MarkDunk/1st-Year-ESE-Multimeter/Multimeter.pdf

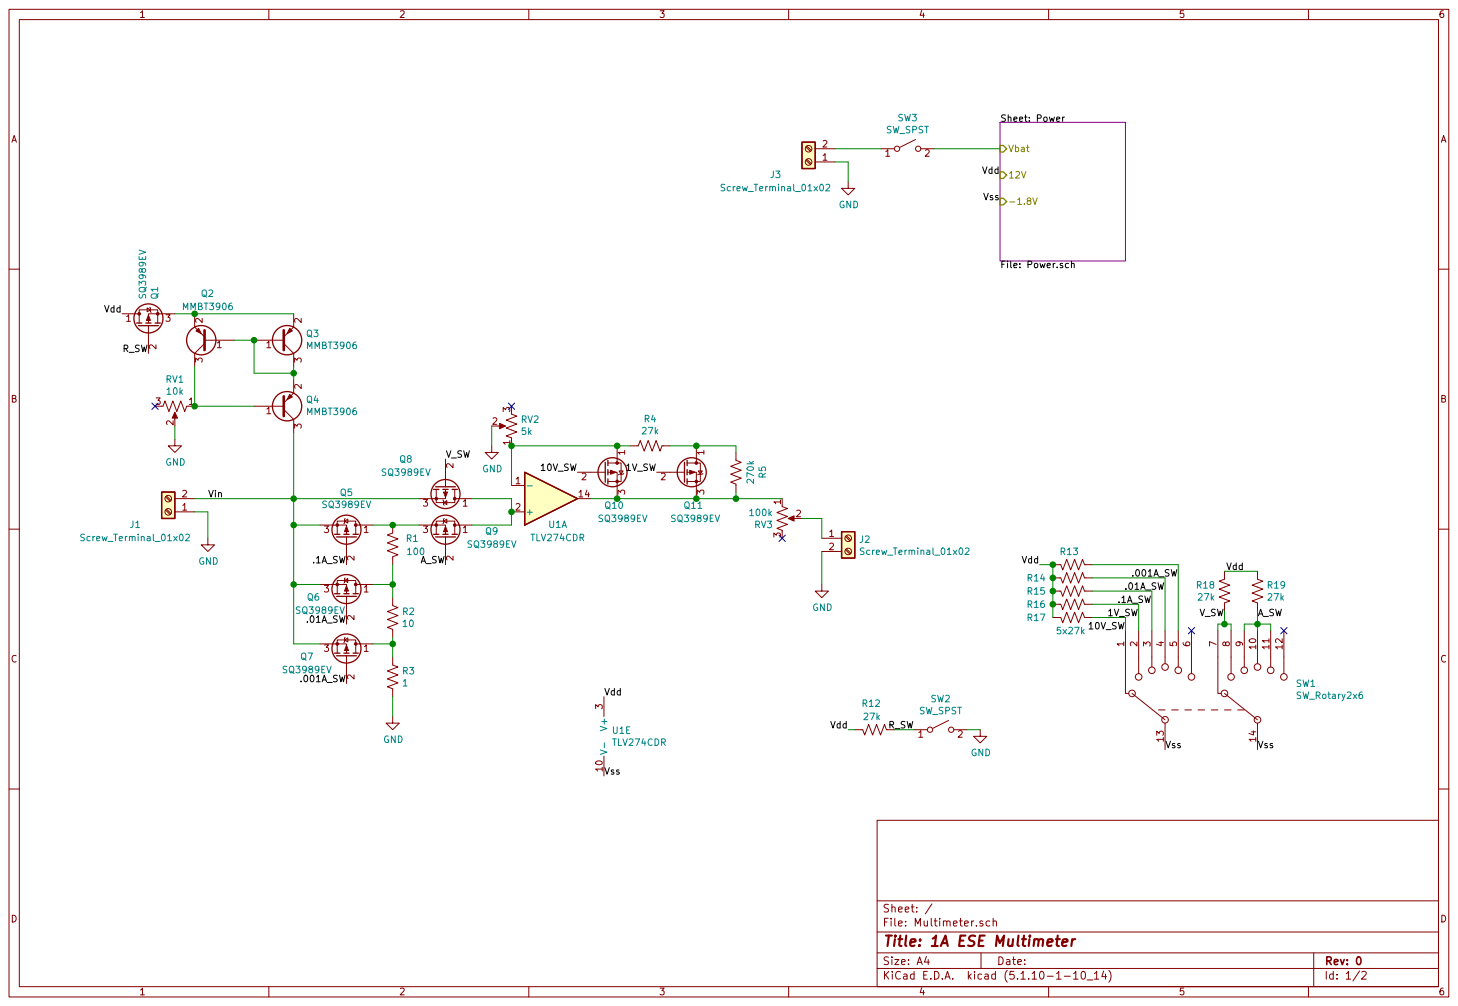
[picture p1: page 1]

Sheet: Power File: Power.sch Vbat -1.8V

Id: 1/2 Title: 1A ESE Multimeter File: Multimeter.sch Sheet: /

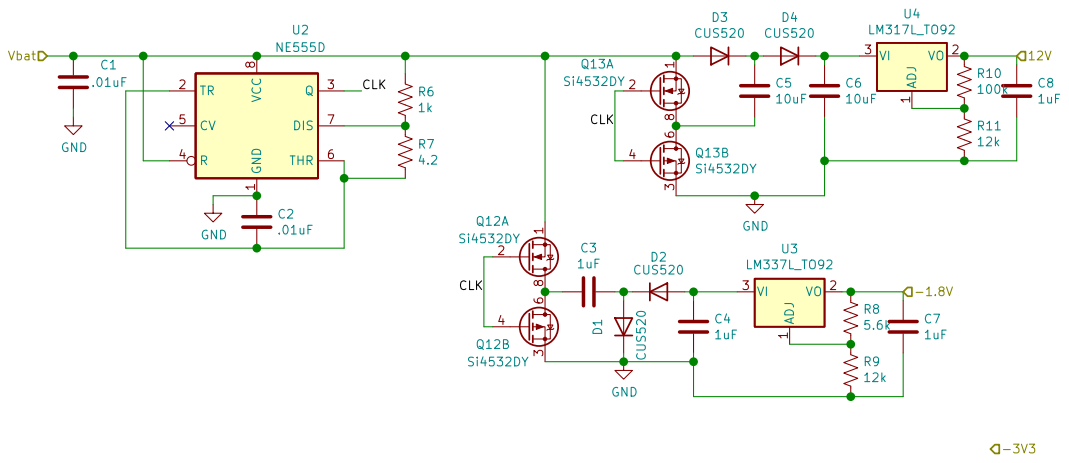
[picture p2: page 2]
