MarkDunk/1st-Year-ESE-Multimeter/PDFs/Multimeter.pdf

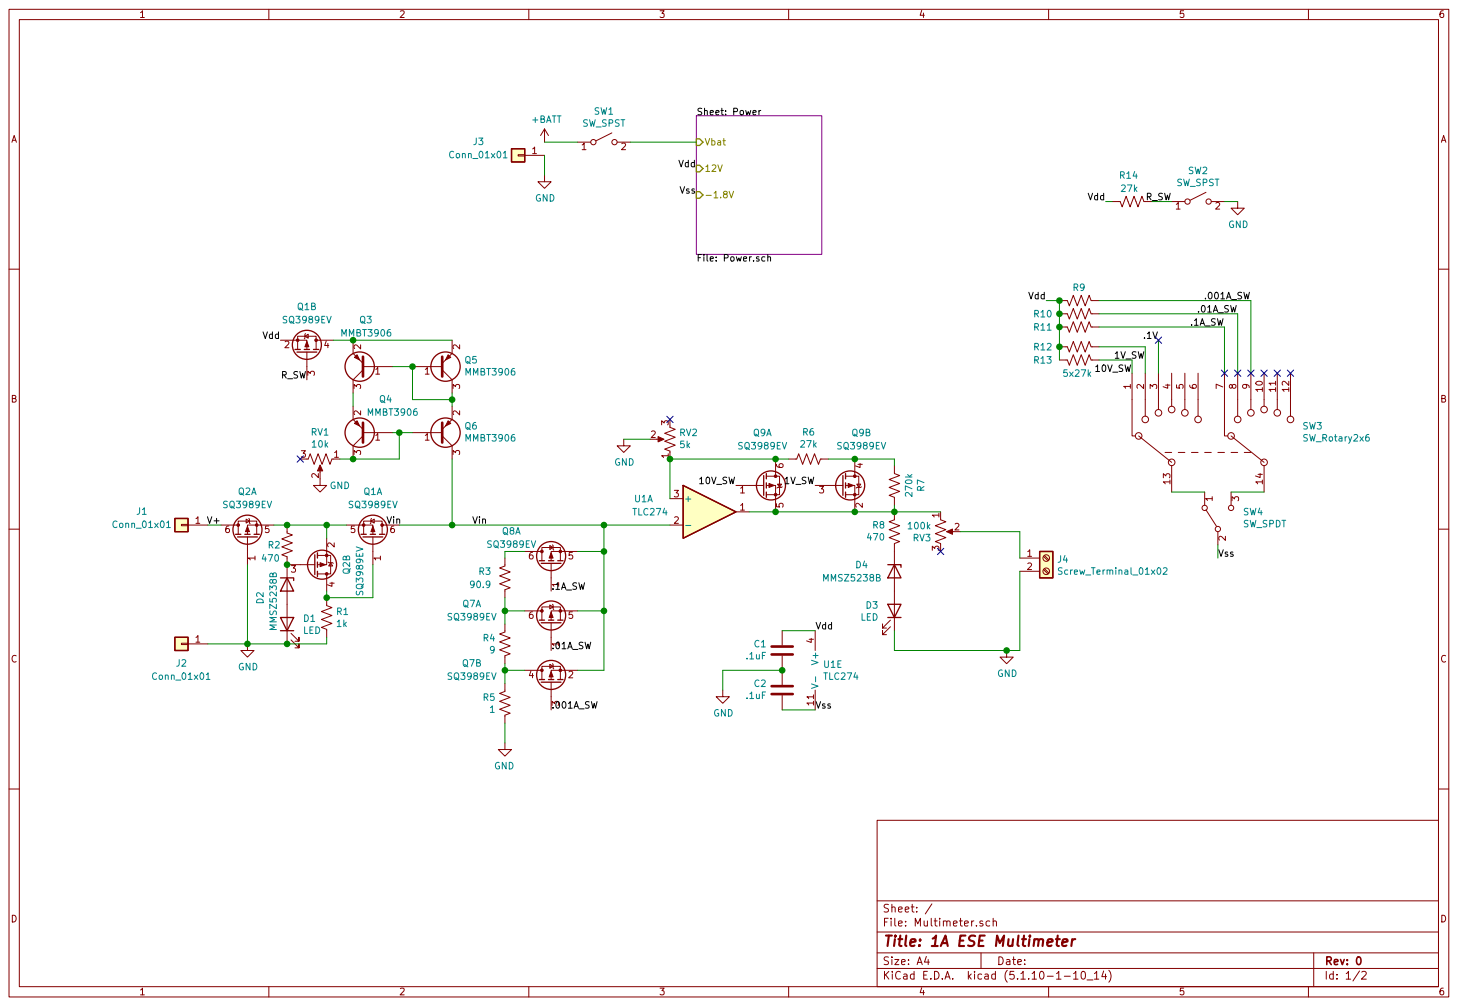
[picture p3: page 1]

Sheet: Power File: Power.sch Vbat -1.8V

9 SW3 SW_Rotary2x6 V+ Vin Vdd Vss Vin Vdd R_SW

Id: 1/2 Title: 1A ESE Multimeter File: Multimeter.sch Sheet: /

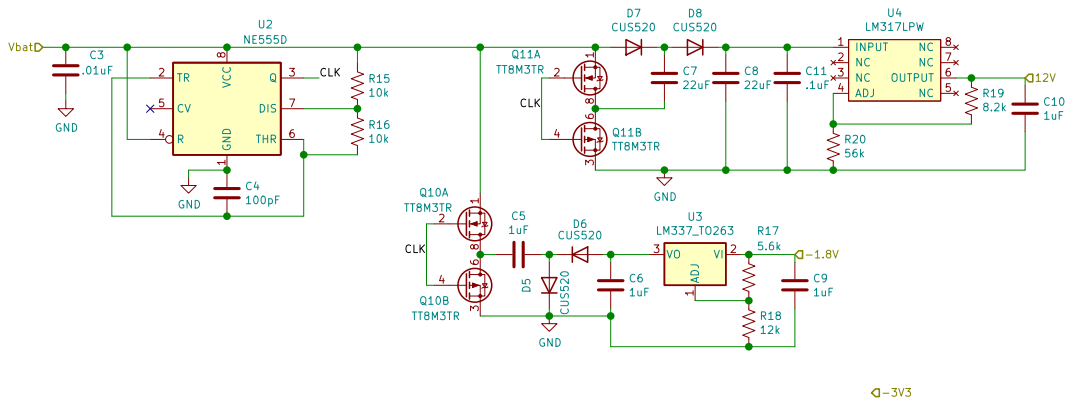
[picture p4: page 2]
