MarkDunk/1st-Year-ESE-Multimeter/Multimeter.kicad_pcb

## KiCad design Multimeter.kicad_pcb (2021-10-18)

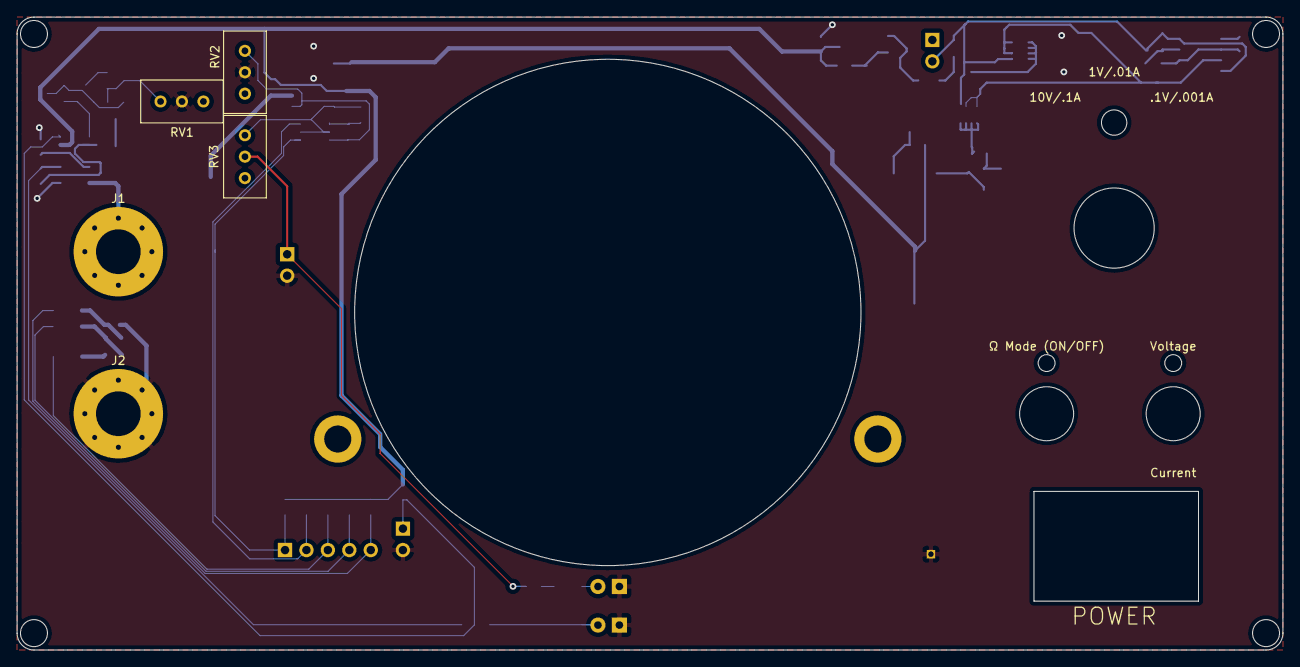
[picture p5: board Multimeter.kicad_pcb from above]

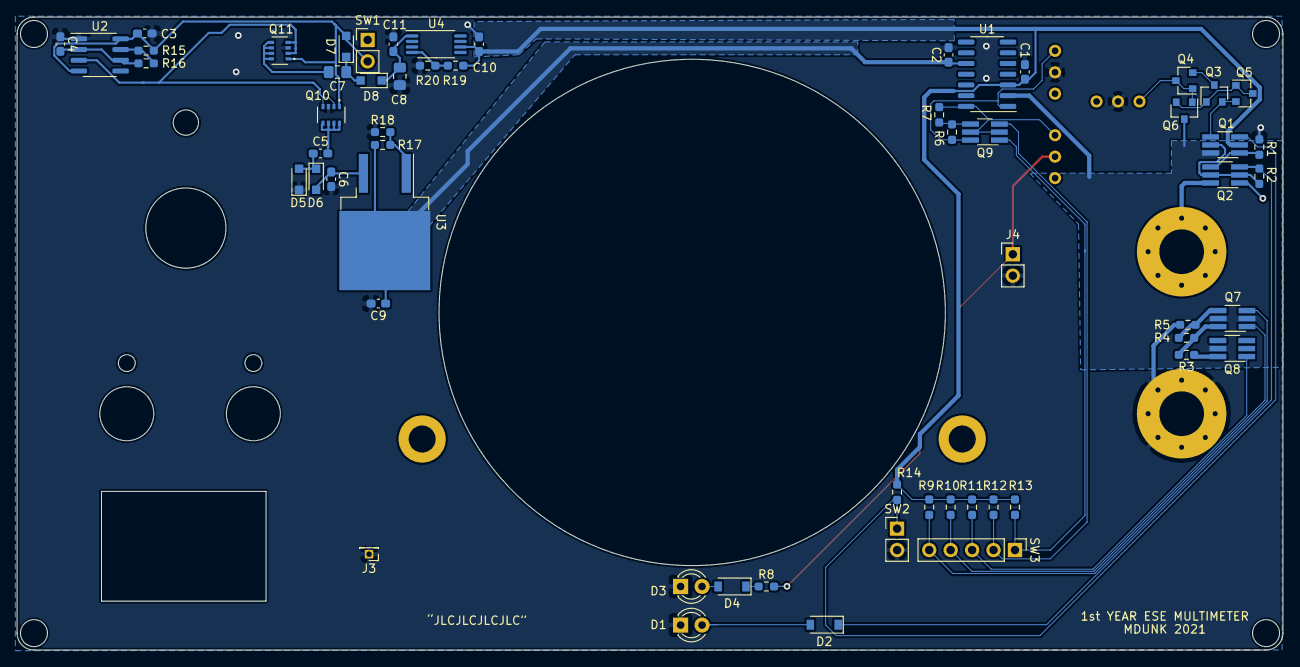
[picture p6: board Multimeter.kicad_pcb from below]

Board: 2 copper layers, 150.0 x 75.0 mm, 64 parts (59 on the bottom side), 40 nets.

Parts:
C1, C2, C11: .1uF; C_0603_1608Metric_Pad1.08x0.95mm_HandSolder
C3: .01uF; C_0603_1608Metric_Pad1.08x0.95mm_HandSolder
C4: 100pF; C_0603_1608Metric_Pad1.08x0.95mm_HandSolder
C5, C6, C9, C10: 1uF; C_0603_1608Metric_Pad1.08x0.95mm_HandSolder
C7, C8: 22uF; C_0805_2012Metric_Pad1.18x1.45mm_HandSolder
D1, D3: LED; LED_D3.0mm
D2, D4: MMSZ5238B; D_SOD-123
D5, D6, D7, D8: CUS520; D_SOD-323_HandSoldering
J1, J2: Conn_01x01; MountingHole_5.3mm_M5_Pad_Via
J3: Conn_01x01; PinHeader_1x01_P1.27mm_Vertical
J4: Screw_Terminal_01x02; PinHeader_1x02_P2.54mm_Vertical
Q1, Q2, Q7, Q8, Q9: SQ3989EV; TSOT-23-6_HandSoldering
Q3, Q4, Q5, Q6: MMBT3906; SOT-23
Q10, Q11: TT8M3TR; TT8M3
R1: 1k; R_0603_1608Metric_Pad0.98x0.95mm_HandSolder
R2, R8: 470; R_0603_1608Metric_Pad0.98x0.95mm_HandSolder
R3: 90.9; R_0603_1608Metric_Pad0.98x0.95mm_HandSolder
R4: 9; R_0603_1608Metric_Pad0.98x0.95mm_HandSolder
R5: 1; R_0603_1608Metric_Pad0.98x0.95mm_HandSolder
R6, R9, R10, R11, R12, R14: 27k; R_0603_1608Metric_Pad0.98x0.95mm_HandSolder
R7: 270k; R_0603_1608Metric_Pad0.98x0.95mm_HandSolder
R13: 5x27k; R_0603_1608Metric_Pad0.98x0.95mm_HandSolder
R15, R16: 10k; R_0603_1608Metric_Pad0.98x0.95mm_HandSolder
R17: 5.6k; R_0603_1608Metric_Pad0.98x0.95mm_HandSolder
R18: 12k; R_0603_1608Metric_Pad0.98x0.95mm_HandSolder
R19: 8.2k; R_0603_1608Metric_Pad0.98x0.95mm_HandSolder
R20: 56k; R_0603_1608Metric_Pad0.98x0.95mm_HandSolder
RV1: 10k; Potentiometer_Bourns_3296W_Vertical
RV2: 5k; Potentiometer_Bourns_3296W_Vertical
RV3: 100k; Potentiometer_Bourns_3296W_Vertical
SW1, SW2: SW_SPST; PinHeader_1x02_P2.54mm_Vertical
SW3: SW_Rotary2x6; PinHeader_1x05_P2.54mm_Vertical
U1: TLV274CDR; SOIC-14_3.9x8.7mm_P1.27mm
U2: NE555D; SOIC-8_3.9x4.9mm_P1.27mm
U3: LM337_TO263; TO-263-2
U4: LM317LPW; TSSOP-8_4.4x3mm_P0.65mm

Connections:
/1V_SW: Q9.3, R12.2, SW3.2
/10V_SW: Q9.1, R13.2, SW3.1
/.001A_SW: Q7.3, R9.2, SW3.6
/.01A_SW: Q7.1, R10.2, SW3.5
/.1A_SW: Q8.1, R11.2, SW3.4
/Power/CLK: Q10.2, Q10.4, Q11.2, Q11.4, U2.3
/Power/Vbat: C3.1, D7.2, Q10.1, Q11.1, R15.1, SW1.2, U2.4, U2.8
/R_SW: Q1.3, R14.2, SW2.1
/V+: J1.1, Q2.6
/Vdd: C1.2, C10.1, Q1.2, R9.1, R10.1, R11.1, R12.1, R13.1, R14.1, R19.2, U1.3, U4.6
/Vin: Q1.6, Q6.3, Q7.2, Q7.5, Q8.5, U1.2
/Vss: C2.1, C9.1, R17.2, U1.10, U3.2
GND: C1.1, C2.2, C3.2, C4.1, C6.2, C8.2, C9.2, C10.2, C11.2, D1.1, D3.1, D5.1, J2.1, J3.1, J4.2, Q2.1, Q10.3, Q11.3, R1.2, R5.2, R18.1, R20.1, RV1.2, RV2.2, SW2.2, U2.1
unnamed: C4.2, R16.2, U2.2, U2.6
unnamed: C5.1, D5.2, D6.1
unnamed: C5.2, Q10.5, Q10.6, Q10.7, Q10.8
unnamed: C6.1, D6.2, U3.3
unnamed: C7.1, D7.1, D8.2
unnamed: C7.2, Q11.5, Q11.6, Q11.7, Q11.8
unnamed: C8.1, C11.1, D8.1, U4.1
unnamed: D1.2, D2.2
unnamed: D2.1, Q2.3, R2.2
unnamed: D3.2, D4.2
unnamed: D4.1, R8.1
unnamed: J4.1, R8.2, RV3.2
unnamed: Q1.1, Q2.4, R1.1
unnamed: Q1.4, Q3.2, Q5.2
unnamed: Q1.5, Q2.2, Q2.5, R2.1
unnamed: Q3.1, Q5.1, Q5.3, Q6.2
unnamed: Q3.3, Q4.2
unnamed: Q4.1, Q4.3, Q6.1, RV1.1
unnamed: Q7.4, R4.2, R5.1
unnamed: Q7.6, R3.2, R4.1
unnamed: Q8.6, R3.1
unnamed: Q9.2, Q9.5, R7.1, RV3.1, U1.14
unnamed: Q9.4, R6.1, R7.2
unnamed: Q9.6, R6.2, RV2.1, U1.1
unnamed: R15.2, R16.1, U2.7
unnamed: R17.1, R18.2, U3.1
unnamed: R19.1, R20.2, U4.4
