MarkDunk/1st-Year-ESE-Multimeter/(commit log)

2021-10-18 First version of the multimeter.
    This is the first complete version.
    [Multimeter-B_Cu.gbl, Multimeter-B_Mask.gbs, Multimeter-B_Paste.gbp, Multimeter-B_SilkS.gbo, Multimeter-Edge_Cuts.gm1, Multimeter-F_Cu.gtl, Multimeter-F_Mask.gts, Multimeter-F_Paste.gtp]
2021-10-22 Fixed symbol mismatch
    The pins for the TLV274 symbol were incorrect.
    [Multimeter.sch, Power.sch]
